Smardens/Smarduino/Diagrams/Arduino_Main_System.png

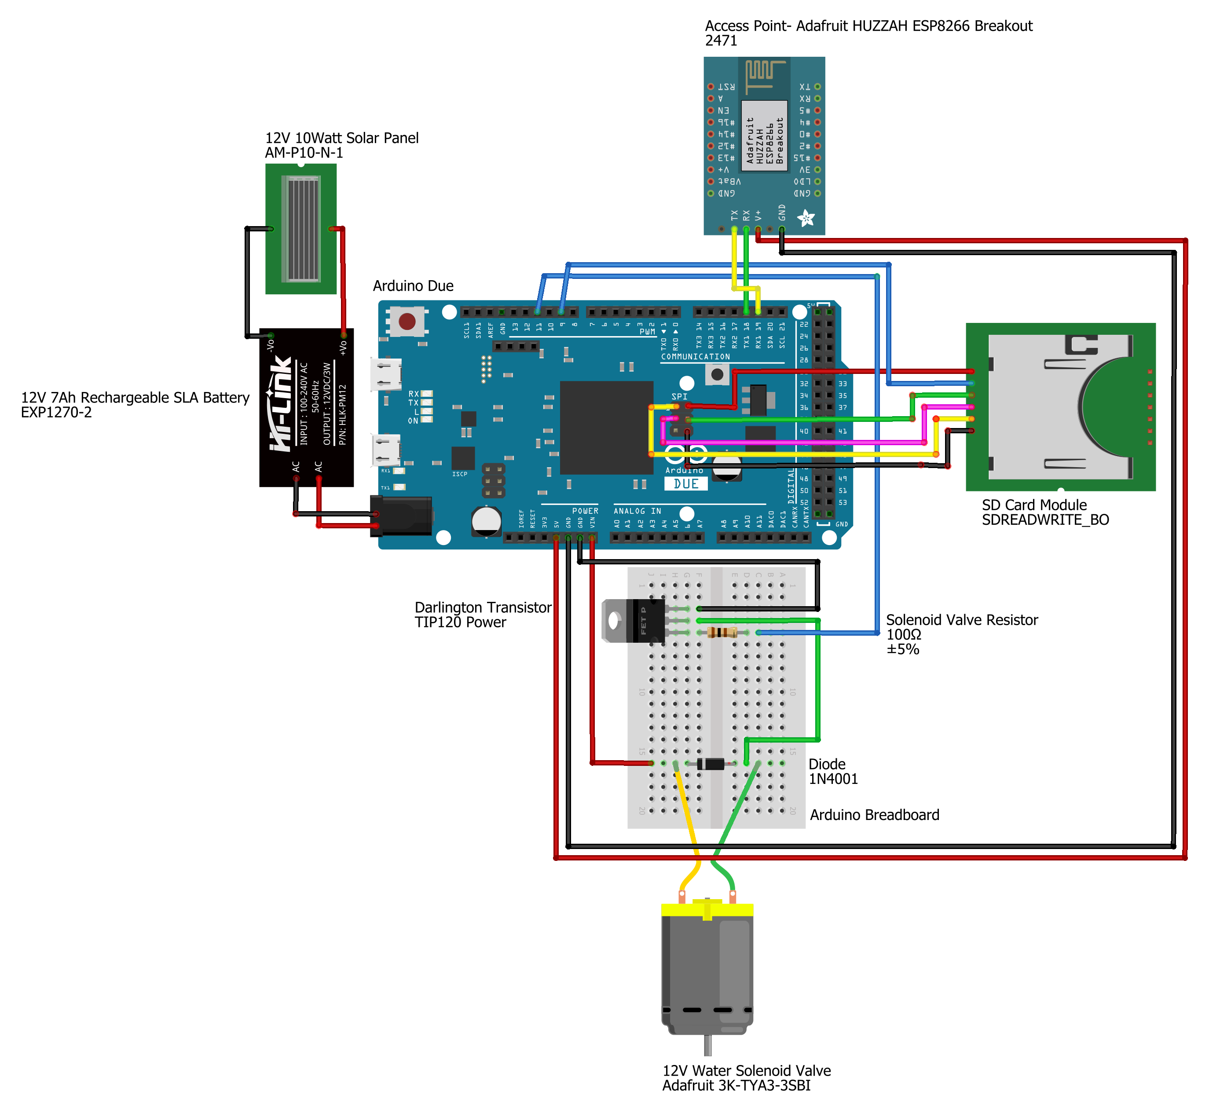
Diagrams/Arduino_Main_System.png
