Smardens/Smarduino/Diagrams/HT_WIFI_Module.png

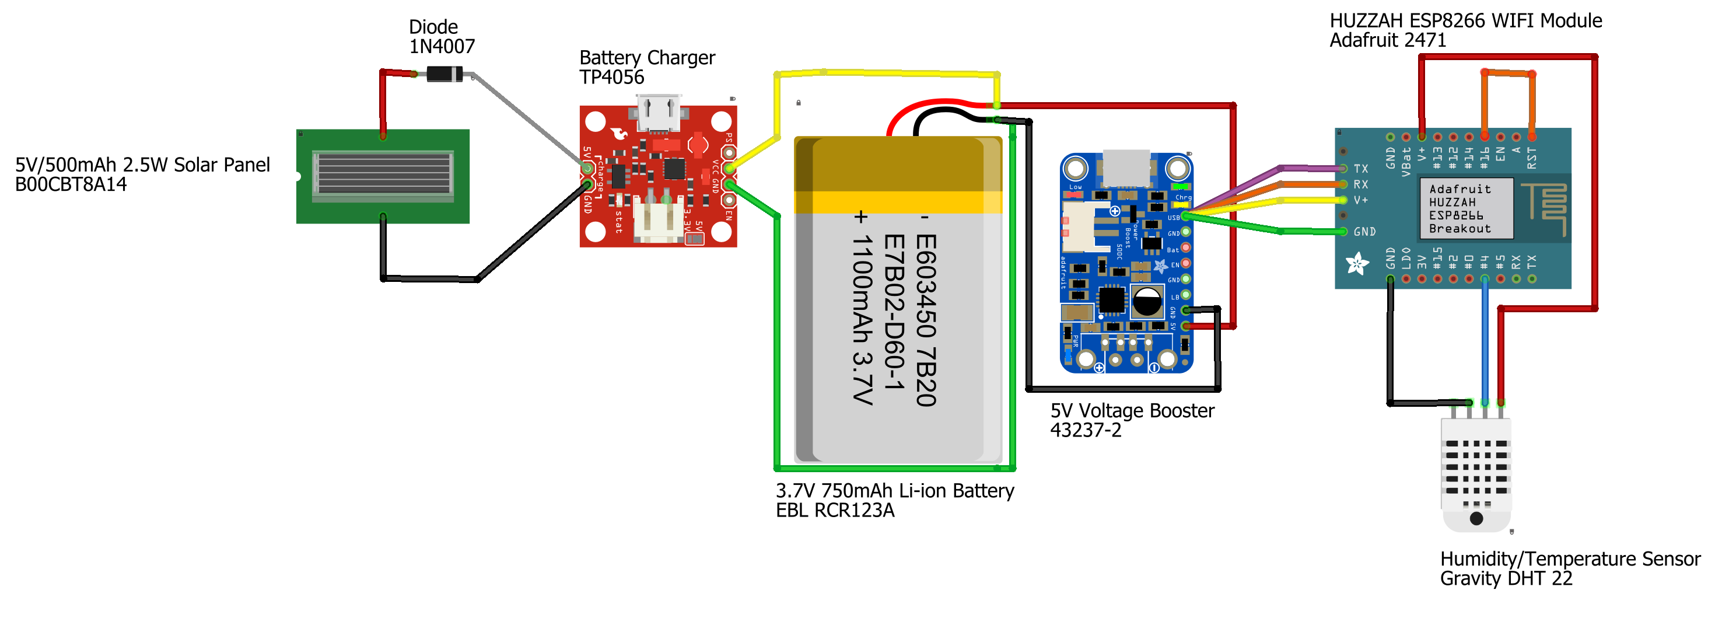
Diagrams/HT_WIFI_Module.png
