Smardens/Smarduino/Diagrams/SM_WIFI_Module.png

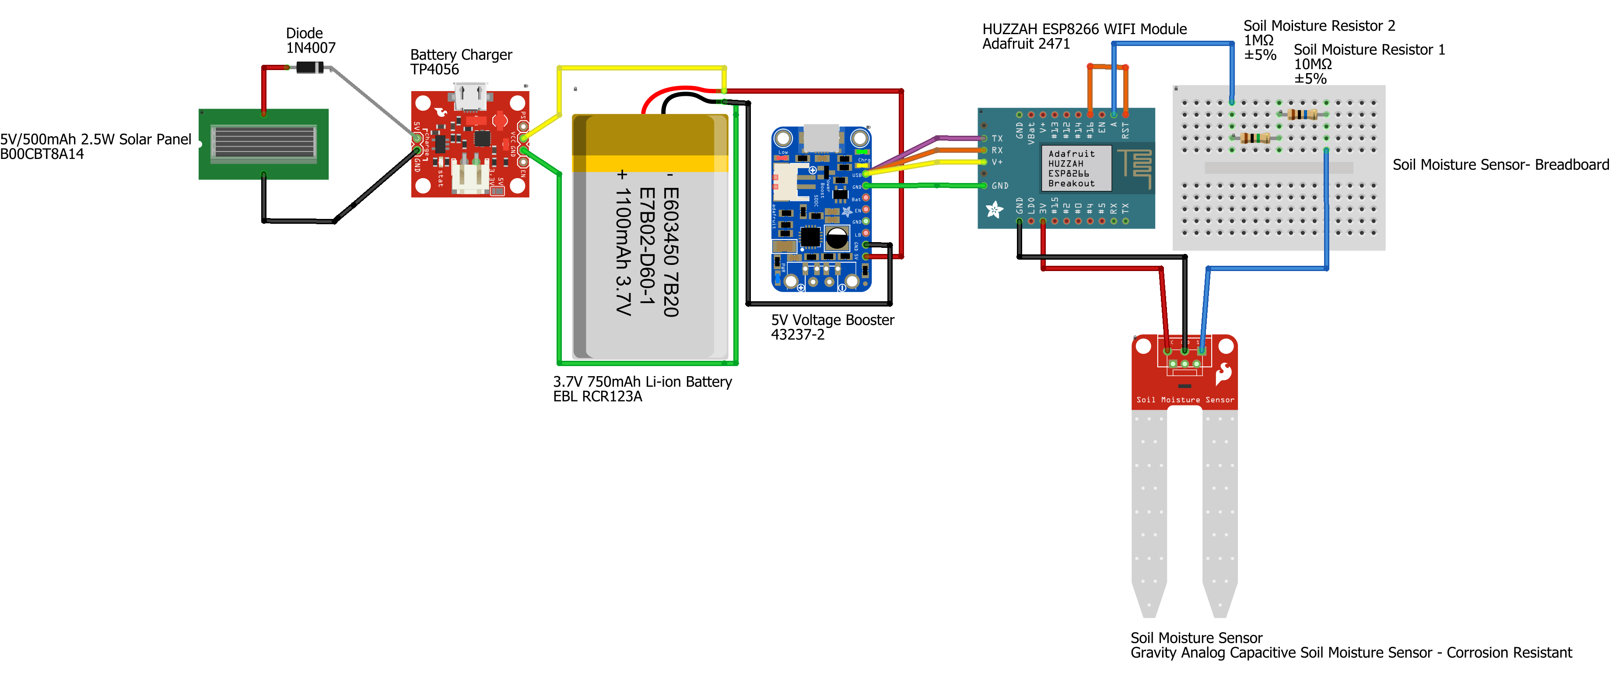
Diagrams/SM_WIFI_Module.png
