Smardens/Smarduino/Diagrams/UV_WIFI_Module.png

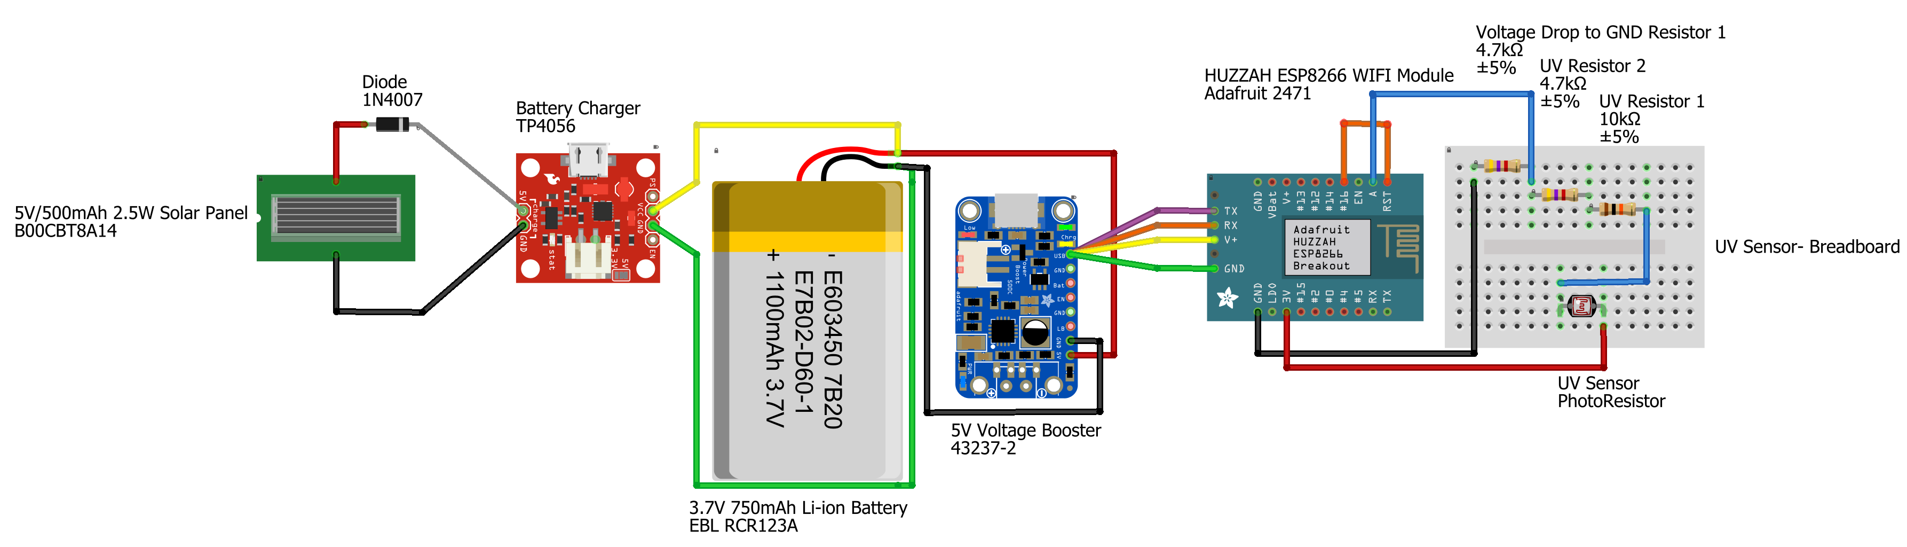
Diagrams/UV_WIFI_Module.png
