Smardens/Smarduino/Diagrams/Water Solenoid Valve (Testing).png

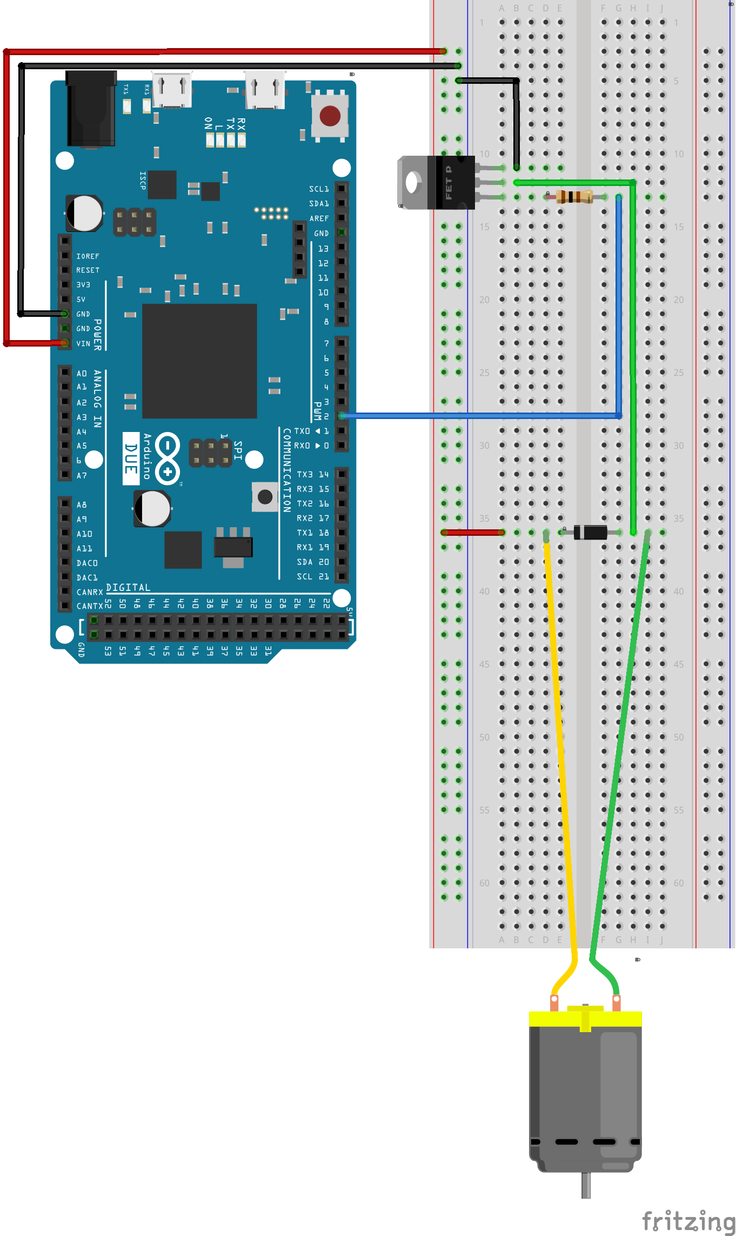
Diagrams/Water Solenoid Valve (Testing).png
