Smardens/Smarduino/(threads)

Thread 11 (2018-09-04):

Fix the Valve Sensor

caitlinrubia, 2018-09-04:
Checking whether current valve is working by reprogramming and testing with high voltage battery. If it fails, well need to buy a new valve sensor and re-program it to open and close at 10 second intervals.

caitlinrubia, 2018-09-18:
Valve opens and closes every 5 seconds on an infinite loop. Valve is wired on to a board. Valve will need to be programmed to open when soil is dry and water is needed. Valve control is programmed to digital pin 4.

Closed 2018-09-18.

Thread 12 (2018-09-04):

Programming WIFI Module

caitlinrubia, 2018-09-04:
WIFI Module is able to retrieve sensor data and send to Arduino.

WIFI Module is able is send data from the Arduino to the database

BriianPowell, 2018-09-18:
Issue with easyIoT receiving multiple parameters from temp/humidity sensor
May have to buy easyIoT

Thread 13 (2018-09-04):

Create myGarden Profile Template Page to display containers to show sensor readings, crop table, watering schedule table, gardening tips, and functionality buttons.

caitlinrubia, 2018-09-04:
myGarden Profile contains the containers for the crop table, graph of overall garden status, buttons for creating and removing.

Creating sensor check button- functionality will be complete later

xinyichen8, 2018-09-18:
I go to W3 schools to refresh my knowledge on how to create <div>, table and buttons in order to create the template. The page contains boxes where additional functionality will be added to the box in future tasks.

Closed 2018-09-16.

Thread 17 (2018-09-04):

Wiring Solar Battery and Test with Arduino, WiFi Module, and sensors

caitlinrubia, 2018-09-04:
-Solder and build the solar battery with the solar panel and rechargeable battery

Wiring the 7 solar batteries to power 6 sensors and 1 arduino

caitlinrubia, 2018-09-24:
Solder the battery, battery charger, and voltage booster.
*Blocker- needed to purchase extra materials (diodes) to solder to the solar panels
*Still needing to test.

caitlinrubia, 2018-09-26:
Wired 6 solar powered batteries that will be used for the 5 wifi modules that will transmit soil moisture sensors readings and 1 wifi module that will transmit UV and humidity/temperature sensor readings.
-Tested power of battery on LED= *Blocker- not outputting enough voltage to power other components
*Still need to solder solar battery to power arduino, solenoid valve, and 1 wifi module for the UV and humidity/ temperature sensor readings.

caitlinrubia, 2018-10-02:
Refining the solar batteries to make them durable and sustain the garden by covering the battery and wiring to prevent water damage

Closed 2018-10-07.

Thread 19 (2018-09-05):

Implement Water Schedule: Create water schedule in Arduino to do automatic watering.

caitlinrubia, 2018-09-05:
Functionality allows one to add crop information and customize watering amount. Signals Arduino to automatize watering

caitlinrubia, 2018-10-05:
Watering schedule cannot be customized on the user account using the website. See Issue 57 for change

Thread 21 (2018-09-05):

Implementing Sensor Check: Sensor check button will test the functionality of the sensors by capturing latest sensor data and comparing to each other and previous hour data to determine sensor failure

caitlinrubia, 2018-09-05:
Functionality allows user to use web application to test whether certain sensors are working properly.

xinyichen8, 2018-10-15:
sensor check is implemented and allow the user to check the status of the sensors.

Thread 26 (2018-09-05):

Deployment Week 1

caitlinrubia, 2018-09-05:
Noting and summarizing crop information (height, width, bearing produce, pest influence, weather influence)

Noting watering scheduled time

caitlinrubia, 2018-10-30:
Deployed wireless sensors with garden. When checking the battery power for the arduino and valve, it wasnt being fully powered due to lack of sun.

Thread 28 (2018-09-05):

Deployment Week 3

caitlinrubia, 2018-09-05:
Noting and summarizing crop information (height, width, bearing produce, pest influence, weather influence)

Noting watering scheduled time

caitlinrubia, 2018-11-08:
System isnt functioning due to lack of sunlight because a tree is covering our whole plot.

caitlinrubia, 2018-11-08:
UV and and soil moisture sensors dont return accurate values due to too high of input voltage for the data input. Brian and I are working with two EE students to determine how to get accurate readings.

caitlinrubia, 2018-11-08:
Talked with Professor Ary and recommended to change in resistors to control the voltage drop. We tried this approach but readings were still inaccurate. We will be talking to Professor Hill.

Thread 29 (2018-09-05):

Deployment Week 2

caitlinrubia, 2018-09-05:
Noting and summarizing crop information (height, width, bearing produce, pest influence, weather influence)

Noting watering scheduled time

caitlinrubia, 2018-11-08:
Edited watering system code to water when readings are inaccurate.(Catch all case)

caitlinrubia, 2018-11-08:
Sensors and watering system arent being charged fully to power the system. Looking into a workarounds

Thread 30 (2018-09-05):

Final Deployment Week 4

caitlinrubia, 2018-09-05:
Noting and summarizing crop information (height, width, bearing produce, pest influence, weather influence)

Noting watering scheduled time

caitlinrubia, 2018-11-08:
Moved system to trying and capture more light to power the arduino and valves

caitlinrubia, 2018-11-13:
Decided against moving the system. Replugged in system and updated code to wire when initially powered. Recorded status of crop. Many weeds have appeared and another larger crop and potatoes were found.

Thread 36 (2018-09-13):

Revise Specifications for All Documentation

caitlinrubia, 2018-09-13:
-	Revise documents from last semester
o	Design Specifications
o	Requirement Specifications
o	User Guide
o	Developer Guidelines
o	FAQs

xinyichen8, 2018-09-27:
Revising requirement specification document: Stage 1: fixing goal model.

xinyichen8, 2018-09-27:
Stage 2: fixing use case model

caitlinrubia, 2018-11-08:
Adding electrical diagrams to explain the the wiring and connection of all the components

caitlinrubia, 2018-12-07:
Revising the diagrams and the design specification document. Updating the sprint plan to reflect real actions

Thread 38 (2018-09-13):

Create Powerpoint Presentation and Add Content

caitlinrubia, 2018-09-13:
Determine who is presenting which sections

caitlinrubia, 2018-11-27:
After meeting with Birgit two weeks ago, we will be revising our old power point and add current information. Also mark out the length of the garden deploy and the web app.

ScottGrogin, 2018-11-27:
Edited slides

xinyichen8, 2018-11-27:
Edit slides and prepare for presentation.

caitlinrubia, 2018-11-27:
Broke down timing of presentation (20 mins)
- 13 mins for 13 presentation slides
-3 mins for web app demo
-3 mins for garden deploy
-1 min for Q/A

Thread 51 (2018-09-26):

Wire Solenoid Valve to WIFI Module then attach to Arduino

caitlinrubia, 2018-09-26:
Wired solenoid valve to the WIFI Module to embed switch based on collective data sent to the  Arduino

Thread 56 (2018-10-02):

Program Water Valve Connected to Arduino

BriianPowell, 2018-10-02:

xinyichen8, 2018-10-08:
Valve opens according to the most current soil moisture level. The system can water up to twice per day with duration of 2.5 min or 5 min depending on the dryness of the land.

xinyichen8, 2018-10-09:
The valve will opens according to the humidity, temperature, UV and the dryness of the soil now. The watering amount is also based on that information.

Thread 57 (2018-10-02):

Research how wifi module broadcast a network for collective wifi modules

caitlinrubia, 2018-10-02:
Workaroud for Inability to use School Wifi

caitlinrubia, 2018-10-05:
The ESP8266 attached to the Arduino will act as the WIFI access point for the other ESP8266 Modules.

Thread 58 (2018-10-05):

Solder the SD Card module reader and Program it to read and write the sensor data

caitlinrubia, 2018-10-05:
To determine when to open the value the algorithm for the water schedule was determined

caitlinrubia, 2018-10-12:
Only about to write code for the writer to the SD. I will be working on the read for next iteration.

Thread 66 (2018-10-09):

Program ESP to Arduino Communication

BriianPowell, 2018-10-09:

caitlinrubia, 2018-10-23:
ESP is able to send sensor data string to Arduino through TX RX serial communication. The data string is parsed into folders and text files.

Thread 67 (2018-10-09):

Program Arduino to SD Card Store

BriianPowell, 2018-10-09:

caitlinrubia, 2018-10-23:
Arduino can read data and store sensor reading based on Sensor ID type and number. Folders are created based on date and time.
