Smardens/Smarduino/Code/Sensor_TestSketches/Solenoid_Test_Sketch/waterSolenoidTest_Sketch.ino

int solenoidPin = 2;    //This is the output pin on the Arduino we are using
void setup() {
  // put your setup code here, to run once:
  pinMode(solenoidPin, OUTPUT);           //Sets the pin as an output
  
}

void loop() {
  
  // put your main code here, to run repeatedly:
  digitalWrite(solenoidPin, HIGH);    //Switch Solenoid ON
  delay(1000);                      //Wait 1 Second
  digitalWrite(solenoidPin, LOW);     //Switch Solenoid OFF
  delay(1000);                      //Wait 1 Second
}
