Smardens/Smarduino/(commit log)

2018-05-01 Add solenoid valve test
2018-05-01 Added water valve diagram, add valve test, change orginazational structure of repository
2018-05-02 Test code for humidity sensors
2018-05-07 Added Humidity Temperature Sensor Test Code (Needed github libraries- adafruit/ DHT-sensor-library and adafruit-sensor-library)
2018-09-11 added UV sensor code
2018-09-13 Moved old test sketches to their own folder. Added Wifi tempurature sensor code, still need to figure out workaround for WPA2-enterprise school wifi, works on home wifi
    [HumidityTempSensor_Test.ino, soilMostureSensor_Sketch.ino, waterSolenoidTest_Sketch.ino]
2018-09-18 Updated Temp/Humid sensor to include both
2018-10-02 Fixed UV, SoilMoisture, TempHumidity sensors to transmit data to easyiot. Still need to fix an issue with the autogenerated tokens
2018-10-09 Added tester files to initialize the SD card for the Arduino Due specifically, edited tester for creating file, reading/writing to the file, and deleting file
2018-10-16 Fixed wording and minor changes
    [WiFi_AP_ConnectDHT.ino, WiFi_AP_ConnectSM.ino, WiFi_AP_ConnectUV.ino, WiFi_AP_Start.ino]
2018-10-17 watering schedule 2- wireless
2018-10-18 added SPI library
2018-10-27 resturctured file system and added handling for failed sensor readings in watering system
    [Watering_Scheudule_2.ino, Watering_Scheudule_3.ino]
2018-11-06 Updated watering schedule for handling unknown sensor readings
2018-11-08 added wiring diagrams of embedded systems
2018-11-15 editted UV wifi to produce a more accurate light range scale and edited watering schedule to water when reset
    [Watering_Scheudule_3.ino, WiFi_AP_ConnectUV.ino]
